johnwargo/Arduino-Twinkle-Lights/(commit log)

2017-01-03 switched to single loop
2017-01-07 fixed a type in the comments
    [twinkle_lights.ino]
2022-11-11 Create Arduino Twinkle Lights.pdf
